BlakeGarner/open-source-rover/Electrical/Electrical Parts List.xlsx

Part |  |  | Qty to Buy | Qty In project | SOLD IN PACKS OF | Brand | Ref | Model/Config (If applicable) | Project Section | Price | Cost to Project | Link
Logic Shifter | Already have |  | 2 | 2 | 1 | Adafruit | E11 | 735 | Electrical | $1.50 | $3.00 | Logic Shifter (https://www.adafruit.com/product/735)
Raspberry pi 3 model b | Pololu |  | 1 | 1 | 1 | Amazon | E1 | B | Electrical | $34.99 | $34.99 | https://www.amazon.com/Raspberry-Model-1-2GHz-64-bit-quad-core/dp/B01CD5VC92?s=electronics
Wire Braid | Jaycar | 6mm x2m (4 of) (WH5630) | 1 | 1 | 1 | Amazon | E14 | 100 Ft | Electrical | $25.00 | $25.00 | https://www.amazon.com/PET-Expandable-Braided-Sleeving-10ft/dp/B00ZATM676?th=1
Battery Volt Meter | Jaycar | Digital DC Power Meter with Internal Shunt (MS6170) | 1 | 1 | 1 | Amazon | E15 | N/A | Electrical | $13.24 | $13.24 | Battery Volt Meter (https://www.amazon.com/DROK-Multimeter-6-5-100V-Backlight-Measuring/dp/B017FSED9I)
SD Card | Jaycar |  | 1 | 1 | 1 | Amazon | E16 | 8Gb | Electrical | $9.98 | $9.98 | https://www.amazon.com/SanDisk-Ultra-Micro-Adapter-SDSQUNC-016G-GN6MA/dp/B010Q57SEE?s=electronics
Raspberry pi heatsink |  |  | 1 | 1 | 1 | Amazon | E19 | N/A | Electrical | $6.79 | $6.79 | https://www.amazon.com/Mudder-Aluminum-Heatsink-Cooling-Raspberry/dp/B01GE7Q060
Tamiya Connectors | Jaycar | Deans Connector x2 (PT4450) | 1 | 1 | 1 | Amazon | E23 | E19 | Electrical | $5.57 | $5.57 | https://www.amazon.com/Tamiya-Male-Female-150mm-Venom/dp/B000HKEVH6
Battery | ebay |  | 1 | 1 | 1 | BatterySpace | E12 | Standard Tamiya Connectors | Electrical | $86.95 | $86.95 | http://www.batteryspace.com/li-ion-battery-14-8v-5-2ah-77wh-8a-rate-for-diving-light---un-38-3-passed.aspx
Battery Charger | Jaycar | Universal Professional Balance Charger/Discharger (MB3633) | 1 | 1 | 1 | BatterySpace | E13 | Standard Tamiya Connectors | Electrical | $41.95 | $41.95 | Battery Charger (http://www.batteryspace.com/smart-charger-3-0a-for-14-8v-li-ion-polymer-battery-pack.aspx)
Resistors 10K |  |  | 25 | 4 | 1 | Digikey | E22 | CF14JT10K0CT-ND | Electrical | $0.03 | $0.72 | https://www.digikey.com/product-detail/en/stackpole-electronics-inc/CF14JT10K0/CF14JT10K0CT-ND/1830374
Resistors 22K | Digikey |  | 25 | 4 | 1 | Digikey | E23 | CF14JT22K0CT-ND | Electrical | $0.03 | $0.72 | https://www.digikey.com/product-detail/en/stackpole-electronics-inc/CF14JT22K0/CF14JT22K0CT-ND/1830383
LED Array | Digikey |  | 1 | 1 | 1 | Digikey | E8 | N/A | Electrical | $24.95 | $24.95 | https://www.adafruit.com/product/420
Switch | Jaycar |  | 1 | 1 | 1 | Digikey | E20 | 432-1282-ND | Electrical | $4.49 | $4.49 | https://www.digikey.com/product-detail/en/bulgin/C3900BA/1091-1026-ND/2747857
Roboclaw Motor Driver | Pololu |  | 5 | 5 | 1 | Pololu | E2 | N/A | Electrical | $69.95 | $349.75 | Roboclaw Motor Driver (https://www.pololu.com/product/3284)
5V Buck Boost Regulator | Pololu |  | 1 | 1 | 1 | Pololu | E4 | N/A | Electrical | $14.95 | $14.95 | 5V Buck Boost Regulator (https://www.pololu.com/product/2851)
378:1 Gear Motor w Relative Enc. (Drive Motor) | Pololu |  | 6 | 6 | 1 | Pololu | E5 | N/A | Electrical | $34.95 | $209.70 | 378:1 Gear Motor w Relative Enc. (https://www.pololu.com/product/3270)
172:1 Gear Motor (Corner Motor) | Pololu |  | 4 | 4 | 1 | Pololu | E6 | N/A | Electrical | $19.95 | $79.80 | 172:1 Gear Motor (https://www.pololu.com/product/3232)
3 pin Micro Connectors | US DIGITAL |  | 4 | 4 | 1 | US Digital | E10 | CA-MIC3-W3-NC-1 | Electrical | $6.80 | $27.20 | 3 pin Micro Connectors (https://www.usdigital.com/products/cables-connectors/cables/3-pin/CA-MIC3-W3-NC)
Absolute Encoder | US DIGITAL |  | 4 | 4 | 1 | US Digital | E7 | 1/8 inch, 10 Bit Analog, Ball bearing | Electrical | $55.00 | $220.00 | Absolute Encoder (https://www.usdigital.com/products/encoders/absolute/rotary/shaft/MA3)
Black Wire 30AWG | Pololu |  | 1 | 1 | 1 | Digikey | N/A | C2003B-50-ND | Electrical | $6.32 | $6.32 | https://www.digikey.com/product-detail/en/general-cable-carol-brand/C2003A.11.01/C2003B-50-ND/5226402
Red Wire 30AWG | Pololu |  | 1 | 1 | 1 | Digikey | N/A | C2015R-50-ND | Electrical | $6.14 | $6.14 | https://www.digikey.com/product-detail/en/general-cable-carol-brand/C2015A.11.03/C2015R-50-ND/5226390
White Wire 30AWG | Pololu |  | 1 | 1 | 1 | Digikey | N/A | 1528-1737-ND | Electrical | $4.95 | $4.95 | https://www.digikey.com/product-detail/en/adafruit-industries-llc/3169/1528-1737-ND/6193589
Blue Wire 30AWG | Pololu |  | 1 | 1 | 1 | Digikey | N/A | 1528-1734-ND | Electrical | $4.95 | $4.95 | https://www.digikey.com/product-detail/en/adafruit-industries-llc/3166/1528-1734-ND/6193586
Yello Wire 30AWG | Pololu |  | 1 | 1 | 1 | Digikey | N/A | 1528-1735-ND | Electrical | $4.95 | $4.95 | https://www.digikey.com/product-detail/en/adafruit-industries-llc/3167/1528-1735-ND/6193587
Green Wire 30AWG | Pololu |  | 1 | 1 | 1 | Digikey | N/A | 1528-1736-ND | Electrical | $4.95 | $4.95 | https://www.digikey.com/product-detail/en/adafruit-industries-llc/3168/1528-1736-ND/6193588
Op Amp LM 358P | Digikey |  | 10 | 4 | 1 | Digikey |  | 296-1395-5-ND | Electrical | $0.37 | $3.67 | https://www.digikey.com/product-detail/en/texas-instruments/LM358P/296-1395-5-ND/277042
4.7k Ohm Resistor | Digikey |  | 10 | 1 | 1 | Digikey |  | CF14JT4K70CT-ND | Electrical | $0.04 | $0.40 | https://www.digikey.com/product-detail/en/stackpole-electronics-inc/CF14JT4K70/CF14JT4K70CT-ND/1830366
Heat Shrink Tubing | Already have |  | 1 | 1 | 1 | Amazon |  | 532 pc | Electrical | $7.99 | $7.99 | https://www.amazon.com/Shrink-Tubing-Black-532pcs-innhom/dp/B075WR9FVL
Black Wire 16AWG | Already have |  | 1 | 1 | 1 | Digikey |  | C76512B-50-ND | Electrical | $15.59 | $15.59 | https://www.digikey.com/product-detail/en/general-cable-carol-brand/76512.18.01/C76512B-50-ND/5452547
Black Wire 20AWG | Pololu |  | 1 | 1 | 1 | Digikey |  | CN538B-50-ND | Electrical | $12.56 | $12.56 | https://www.digikey.com/product-detail/en/cnc-tech/1569-20-1-0500-001-1-TS/CN538B-50-ND/7065796
Red Wire 16AWG |  |  | 1 | 1 | 1 | Digikey |  | C76512R-50-ND | Electrical | $15.59 | $15.59 | https://www.digikey.com/product-detail/en/general-cable-carol-brand/76512.18.03/C76512R-50-ND/5452549
Red Wire 20AWG | Pololu |  | 1 | 1 | 1 | Digikey |  | CN541R-50-ND | Electrical | $15.59 | $15.59 | https://www.digikey.com/product-detail/en/cnc-tech/1569-20-1-0500-004-1-TS/CN541R-50-ND/7065799
Jumper Wire Pack | Pololu |  | 5 | 1 | 1 | Adafruit |  | 6inch | Electrical | $3.95 | $19.75 | https://www.adafruit.com/product/826
0.1 Pitch Pin Header (40 pins) | Already have |  | 10 | 5 | 1 | Digikey |  | S1011EC-40-ND | Electrical | $0.59 | $5.90 | https://www.digikey.com/product-detail/en/sullins-connector-solutions/PRPC040SAAN-RC/S1011EC-40-ND/2775214
4 Pin Header | Pololu |  | 20 |  | 1 | Digikey | N/A | S9014E-04-ND | Electrical | $0.35 | $7.00 | https://www.digikey.com/product-detail/en/sullins-connector-solutions/GRPB041VWVN-RC/S9014E-04-ND/1786440
Encoder Board | Seeed |  | 1 | 1 | 1 | Osh Park | E20 | N/A | Electrical | $20.20 | $20.20 | https://oshpark.com/
LED Board | Seeed |  | 1 | 1 | 1 | Osh Park | E21 | N/A | Electrical | $19.65 | $19.65 | https://oshpark.com/
4 and 8 " Female/Female Jumper Wires | Pololu |  | 5 | 5 | 1 | Amazon |  |  | Electrical | 5.99 | $29.95 | https://www.amazon.com/GenBasic-Female-Solderless-Breadboard-Prototyping/dp/B01L5ULRUA?s=electronics
