BlakeGarner/open-source-rover/Electrical/PCB board files and schematics/PiBoard.kicad_pcb

## KiCad design Electrical/PCB board files and schematics/PiBoard.kicad_pcb (2018-08-27)

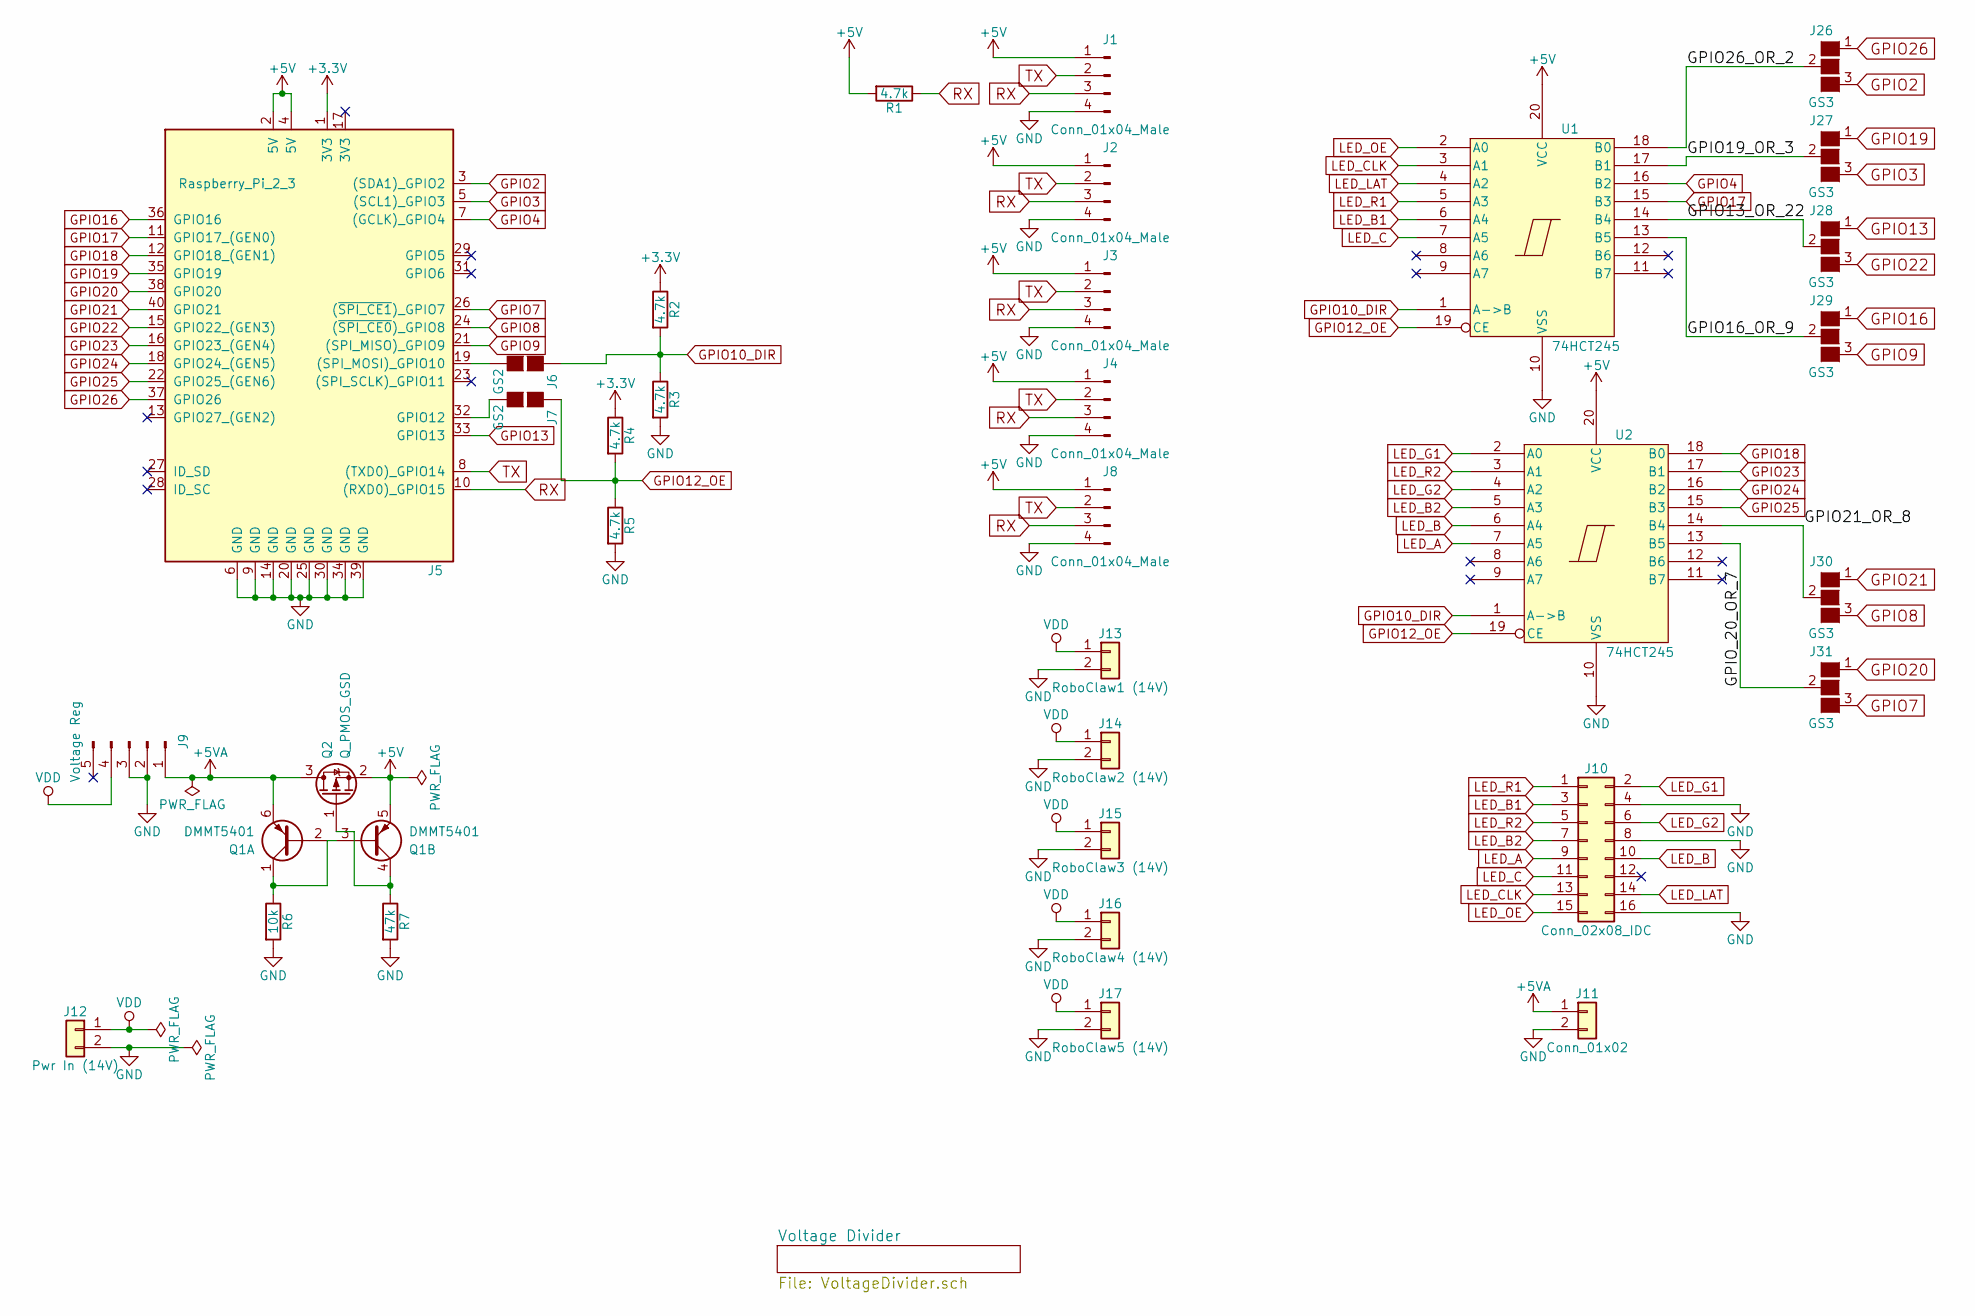
[picture p2: schematic PiBoard.sch, JPL Open Source Rover - Revised Raspberry Pi Interface board]

Parts:
J1, J2, J3, J4, J8: Conn_01x04_Male; Pin_Header_Straight_1x04_Pitch2.54mm
J5: Raspberry_Pi_2_3; Socket_Strip_Straight_Raspberry_Pi_2_3
J6, J7: GS2
J9: Voltage Reg; Pin_Header_Straight_1x05_Pitch2.54mm
J10: Conn_02x08_IDC; Multicomp_MC9A12-1634_2x08x2.54mm_Straight
J11: Conn_01x02; PhoenixContact_GMSTBVA-G_02x7.62mm_Vertical
J12: Pwr In (14V); PhoenixContact_GMSTBVA-G_02x7.62mm_Vertical
J13: RoboClaw1 (14V); TerminalBlock_bornier-2_P5.08mm
J14: RoboClaw2 (14V); TerminalBlock_bornier-2_P5.08mm
J15: RoboClaw3 (14V); TerminalBlock_bornier-2_P5.08mm
J16: RoboClaw4 (14V); TerminalBlock_bornier-2_P5.08mm
J17: RoboClaw5 (14V); TerminalBlock_bornier-2_P5.08mm
J26, J27, J28, J29, J30, J31: GS3
Q1: DMMT5401; SOT-23-6; MPN DMMT5401-7-F; Digikey PN DMMT5401-FDICT-ND
Q2: Q_PMOS_GSD; SOT-23; MPN DMG2305UX-13; Digikey PN DMG2305UX-13DICT-ND
R1, R2, R3, R4, R5: 4.7k; R_0805
R6: 10k; R_0805
R7: 47k; R_0805
U1, U2: 74HCT245; TSSOP-20_4.4x6.5mm_Pitch0.65mm

Connections:
+3V3: J5.1 (3V3), R2.1, R4.1
+5V: J1.1, J2.1, J3.1, J4.1, J5.2 (5V), J5.4 (5V), J8.1, Q1.5 (E2), Q2.2 (S), R1.2, U1.20 (VCC), U2.20 (VCC)
+5VA: J9.1, J11.1, Q1.6 (E1), Q2.3 (D)
/GPIO13_OR_22: J28.2 (G2), U1.14 (B4)
/GPIO16_OR_9: J29.2 (G2), U1.13 (B5)
/GPIO19_OR_3: J27.2 (G2), U1.17 (B1)
/GPIO21_OR_8: J30.2 (G2), U2.14 (B4)
/GPIO26_OR_2: J26.2 (G2), U1.18 (B0)
/GPIO_20_OR_7: J31.2 (G2), U2.13 (B5)
GND: J1.4, J2.4, J3.4, J4.4, J5.6 (GND), J5.9 (GND), J5.14 (GND), J5.20 (GND), J5.25 (GND), J5.30 (GND), J5.34 (GND), J5.39 (GND), J8.4, J9.2, J9.3, J10.4, J10.8, J10.16, J11.2, J12.2, J13.2, J14.2, J15.2, J16.2, J17.2, R3.2, R5.2, R6.2, R7.2, U1.10 (VSS), U2.10 (VSS)
GPIO2: J5.3 ((SDA1)_GPIO2), J26.3 (G3)
GPIO3: J5.5 ((SCL1)_GPIO3), J27.3 (G3)
GPIO4: J5.7 ((GCLK)_GPIO4), U1.16 (B2)
GPIO7: J5.26 ((~SPI_CE1~)_GPIO7), J31.3 (G3)
GPIO8: J5.24 ((~SPI_CE0~)_GPIO8), J30.3 (G3)
GPIO9: J5.21 ((SPI_MISO)_GPIO9), J29.3 (G3)
GPIO10_DIR: J6.1 (G1), R2.2, R3.1, U1.1 (A->B), U2.1 (A->B)
GPIO12_OE: J7.1 (G1), R4.2, R5.1, U1.19 (CE), U2.19 (CE)
GPIO13: J5.33 (GPIO13), J28.1 (G1)
GPIO16: J5.36 (GPIO16), J29.1 (G1)
GPIO17: J5.11 (GPIO17_(GEN0)), U1.15 (B3)
GPIO18: J5.12 (GPIO18_(GEN1)), U2.18 (B0)
GPIO19: J5.35 (GPIO19), J27.1 (G1)
GPIO20: J5.38 (GPIO20), J31.1 (G1)
GPIO21: J5.40 (GPIO21), J30.1 (G1)
GPIO22: J5.15 (GPIO22_(GEN3)), J28.3 (G3)
GPIO23: J5.16 (GPIO23_(GEN4)), U2.17 (B1)
GPIO24: J5.18 (GPIO24_(GEN5)), U2.16 (B2)
GPIO25: J5.22 (GPIO25_(GEN6)), U2.15 (B3)
GPIO26: J5.37 (GPIO26), J26.1 (G1)
LED_A: J10.9, U2.7 (A5)
LED_B: J10.10, U2.6 (A4)
LED_B1: J10.3, U1.6 (A4)
LED_B2: J10.7, U2.5 (A3)
LED_C: J10.11, U1.7 (A5)
LED_CLK: J10.13, U1.3 (A1)
LED_G1: J10.2, U2.2 (A0)
LED_G2: J10.6, U2.4 (A2)
LED_LAT: J10.14, U1.4 (A2)
LED_OE: J10.15, U1.2 (A0)
LED_R1: J10.1, U1.5 (A3)
LED_R2: J10.5, U2.3 (A1)
unnamed: J5.19 ((SPI_MOSI)_GPIO10), J6.2 (G2)
unnamed: J5.32 (GPIO12), J7.2 (G2)
unnamed: Q1.1 (C1), Q1.2 (B1), Q1.3 (B2), R6.1
unnamed: Q1.4 (C2), Q2.1 (G), R7.1
RX: J1.3, J2.3, J3.3, J4.3, J5.10 ((RXD0)_GPIO15), J8.3, R1.1
TX: J1.2, J2.2, J3.2, J4.2, J5.8 ((TXD0)_GPIO14), J8.2
VDD: J9.4, J12.1, J13.1, J14.1, J15.1, J16.1, J17.1

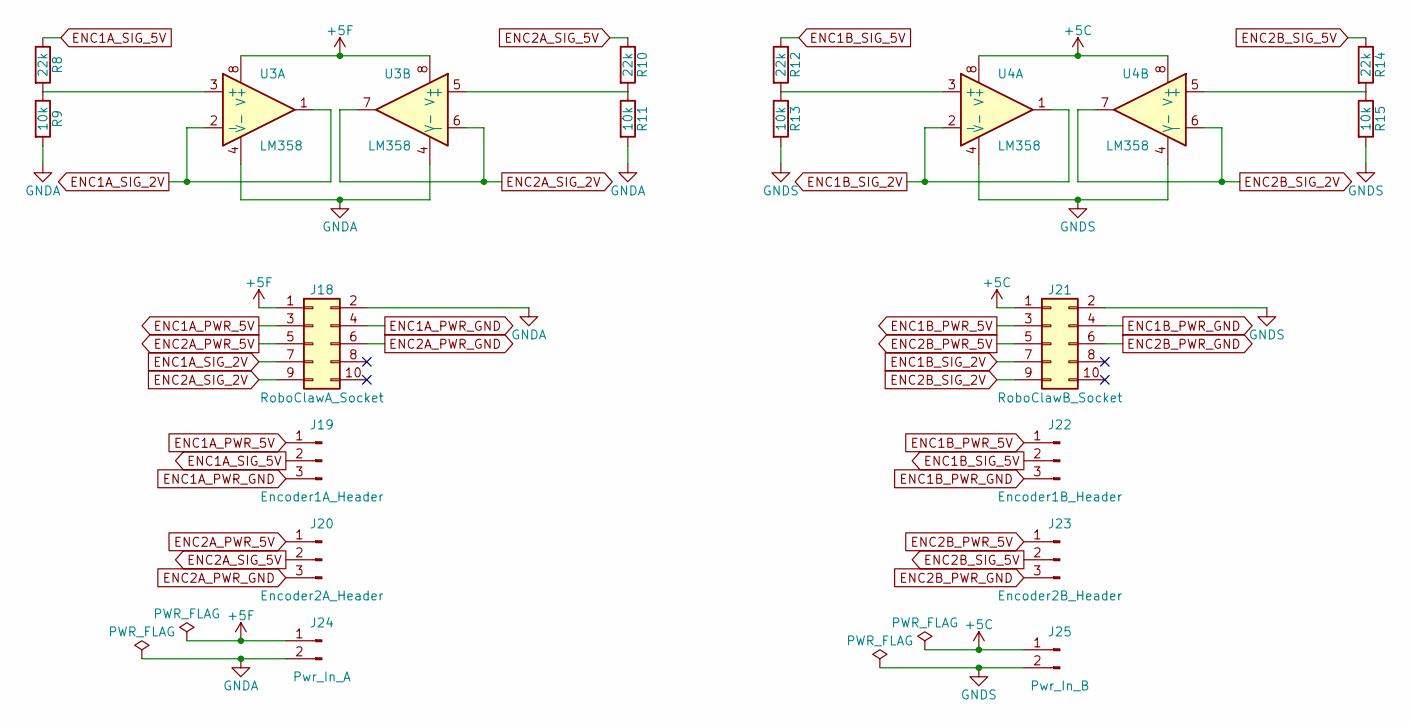
[picture p3: schematic VoltageDivider.sch, Revised Raspberry Pi Interface board]

Parts:
J18: RoboClawA_Socket; Pin_Header_Straight_2x05_Pitch2.54mm
J19: Encoder1A_Header; Pin_Header_Straight_1x03_Pitch2.54mm
J20: Encoder2A_Header; Pin_Header_Straight_1x03_Pitch2.54mm
J21: RoboClawB_Socket; Pin_Header_Straight_2x05_Pitch2.54mm
J22: Encoder1B_Header; Pin_Header_Straight_1x03_Pitch2.54mm
J23: Encoder2B_Header; Pin_Header_Straight_1x03_Pitch2.54mm
J24: Pwr_In_A; Pin_Header_Straight_2x01_Pitch2.54mm
J25: Pwr_In_B; Pin_Header_Straight_2x01_Pitch2.54mm
R8, R10, R12, R14: 22k; R_0805
R9, R11, R13, R15: 10k; R_0805
U3: LM358; SOIC-8_3.9x4.9mm_Pitch1.27mm
U4: LM358; SOIC-8_3.9x4.9mm_Pitch1.27mm; MPN LM358DR; Digikey PN 296-1014-1-ND

Connections:
+5C: J21.1, J25.1, U4.8 (V+)
+5F: J18.1, J24.1, U3.8 (V+)
ENC1A_PWR_5V: J18.3, J19.1
ENC1A_PWR_GND: J18.4, J19.3
ENC1A_SIG_2V: J18.7, U3.1, U3.2 (-)
ENC1A_SIG_5V: J19.2, R8.1
ENC1B_PWR_5V: J21.3, J22.1
ENC1B_PWR_GND: J21.4, J22.3
ENC1B_SIG_2V: J21.7, U4.1, U4.2 (-)
ENC1B_SIG_5V: J22.2, R12.1
ENC2A_PWR_5V: J18.5, J20.1
ENC2A_PWR_GND: J18.6, J20.3
ENC2A_SIG_2V: J18.9, U3.6 (-), U3.7
ENC2A_SIG_5V: J20.2, R10.1
ENC2B_PWR_5V: J21.5, J23.1
ENC2B_PWR_GND: J21.6, J23.3
ENC2B_SIG_2V: J21.9, U4.6 (-), U4.7
ENC2B_SIG_5V: J23.2, R14.1
GNDA: J18.2, J24.2, R9.2, R11.2, U3.4 (V-)
GNDS: J21.2, J25.2, R13.2, R15.2, U4.4 (V-)
unnamed: R8.2, R9.1, U3.3 (+)
unnamed: R10.2, R11.1, U3.5 (+)
unnamed: R12.2, R13.1, U4.3 (+)
unnamed: R14.2, R15.1, U4.5 (+)

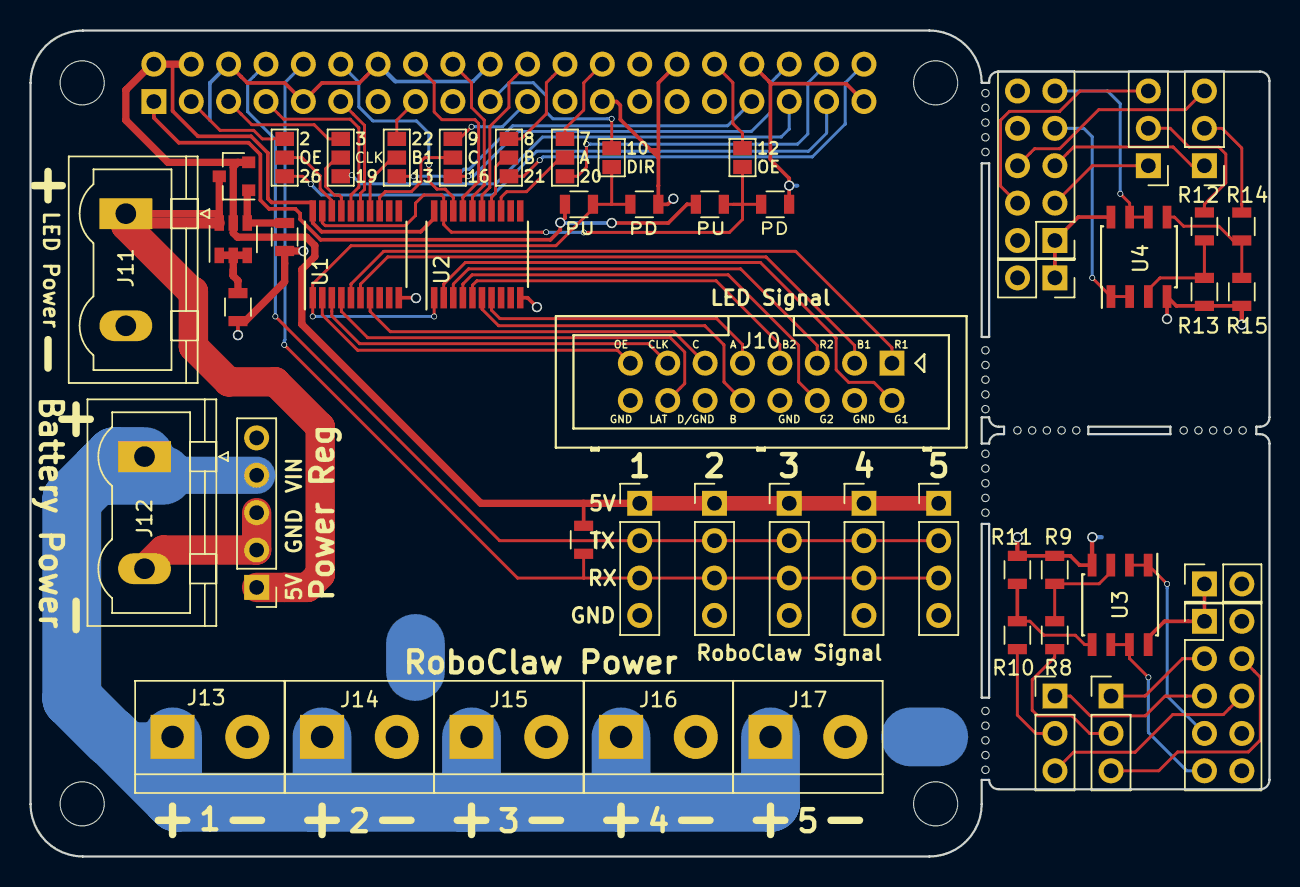
[picture p4: board PiBoard.kicad_pcb from above]

Board: 2 copper layers, 84.2 x 56.1 mm, 52 parts (1 on the bottom side), 73 nets.
