BlakeGarner/open-source-rover/(commit log)

2018-08-27 Final copy of PCB rework
    [Electrical Parts List.xlsx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]
2018-08-27 Switched submodule to local fork
